Bobik128/jetson-bot/src/lerobot_robot_jetsonbot/lerobot_robot_jetsonbot/jetsonbot_client.py

import base64
import json
import logging
from functools import cached_property

import cv2
import numpy as np
import pygame

from lerobot.processor import RobotAction, RobotObservation
from lerobot.utils.constants import ACTION, OBS_STATE
from lerobot.utils.decorators import check_if_already_connected, check_if_not_connected
from lerobot.utils.errors import DeviceNotConnectedError

from lerobot.robots.robot import Robot
from .config_jetsonbot_client import JetsonBotClientConfig

from dataclasses import dataclass
from typing import Dict, Tuple


def clamp(x: float, lo: float, hi: float) -> float:
    return lo if x < lo else hi if x > hi else x


def apply_deadzone(x: float, dz: float) -> float:
    return 0.0 if abs(x) < dz else x


def expo_curve(x: float, expo: float) -> float:
    """
    expo in [0..1]. 0 = linear, 1 = very soft around center.
    """
    x = clamp(x, -1.0, 1.0)
    expo = clamp(expo, 0.0, 1.0)
    return (1.0 - expo) * x + expo * (x * x * x)


class JetsonBotClient(Robot):
    config_class = JetsonBotClientConfig
    name = "jetsonbot_client"

    def __init__(self, config: JetsonBotClientConfig):
        import zmq

        self._zmq = zmq
        super().__init__(config)
        self.config = config
        self.id = config.id
        self.robot_type = config.type

        self.remote_ip = config.remote_ip
        self.port_zmq_cmd = config.port_zmq_cmd
        self.port_zmq_observations = config.port_zmq_observations

        self.teleop_keys = config.teleop_keys

        self.polling_timeout_ms = config.polling_timeout_ms
        self.connect_timeout_s = config.connect_timeout_s

        self.zmq_context = None
        self.zmq_cmd_socket = None
        self.zmq_observation_socket = None

        self.last_frames = {}

        self.last_remote_state = {}

        # Define three speed levels and a current index
        self.speed_levels = [
            {"v": 0.2, "w": 1.0},  # slow
            {"v": 0.3, "w": 2.0},  # medium
            {"v": 0.4, "w": 3.0},  # fast
        ]
        self.speed_index = 0  # Start at slow

        self._is_connected = False
        self.logs = {}

    @cached_property
    def _state_ft(self) -> dict[str, type]:
        return dict.fromkeys(
            (
                "arm_shoulder_lift.pos",
                "arm_elbow_flex.pos",
                "arm_wrist_flex.pos",
                "arm_gripper.pos",
                "motor_linear.vel",
                "motor_angular.vel",
            ),
            float,
        )
    
    @cached_property
    def _obs_state_ft(self) -> dict[str, type]:
        # observation-only state = state_ft + gyro
        return {**self._state_ft, "gyro_yaw.vel": float}
    

    @cached_property
    def _state_order(self) -> tuple[str, ...]:
        return tuple(self._state_ft.keys())
        
    @cached_property
    def _obs_state_order(self) -> tuple[str, ...]:
        # used for observation dict + OBS_STATE vector
        return tuple(self._obs_state_ft.keys())

    @cached_property
    def _cameras_ft(self) -> dict[str, tuple[int, int, int]]:
        return {name: (cfg.height, cfg.width, 3) for name, cfg in self.config.cameras.items()}

    @cached_property
    def observation_features(self) -> dict[str, type | tuple]:
        return {**self._obs_state_ft, **self._cameras_ft}

    @cached_property
    def action_features(self) -> dict[str, type]:
        return self._state_ft

    @property
    def is_connected(self) -> bool:
        return self._is_connected

    @property
    def is_calibrated(self) -> bool:
        pass

    # def read_dualsense_base_action(
    #     self,
    #     js: pygame.joystick.Joystick,
    #     cfg: GamepadConfig = GamepadConfig(),
    # ) -> Dict[str, float]:
    #     """
    #     Read controller axes and return LeRobot base action:
    #         {"motor_linear.vel": v_cmd, "motor_angular.vel": w_cmd}

    #     IMPORTANT: call pygame.event.pump() ONCE per control loop before reading.
    #     """
    #     # Make sure pygame internal state is updated (do this once per loop)
    #     pygame.event.pump()

    #     # Read raw axes in [-1, 1] (typically)
    #     fwd = float(js.get_axis(cfg.axis_forward))
    #     turn = float(js.get_axis(cfg.axis_turn))

    #     if cfg.invert_forward:
    #         fwd = -fwd
    #     if cfg.invert_turn:
    #         turn = -turn

    #     # Deadzone + expo shaping
    #     fwd = expo_curve(apply_deadzone(fwd, cfg.deadzone), cfg.expo)
    #     turn = expo_curve(apply_deadzone(turn, cfg.deadzone), cfg.expo)

    #     # Optional turbo from trigger
    #     scale = 1.0
    #     if cfg.use_turbo:
    #         try:
    #             raw = float(js.get_axis(cfg.axis_turbo))  # often [-1..1]
    #             turbo = (raw + 1.0) * 0.5                # -> [0..1]
    #             turbo = clamp(turbo, 0.0, 1.0)
    #             scale = cfg.turbo_min_scale + (1.0 - cfg.turbo_min_scale) * turbo
    #         except Exception:
    #             scale = 1.0

    #     v_cmd = fwd * cfg.max_v_mps * scale
    #     w_cmd = turn * cfg.max_w_radps * scale

    #     # Final clamp (safety)
    #     v_cmd = clamp(v_cmd, -cfg.max_v_mps, cfg.max_v_mps)
    #     w_cmd = clamp(w_cmd, -cfg.max_w_radps, cfg.max_w_radps)

    #     return {
    #         "motor_linear.vel": v_cmd,
    #         "motor_angular.vel": w_cmd,
    #     }

    @check_if_already_connected
    def connect(self) -> None:
        """Establishes ZMQ sockets with the remote mobile robot"""

        zmq = self._zmq
        self.zmq_context = zmq.Context()
        self.zmq_cmd_socket = self.zmq_context.socket(zmq.PUSH)
        zmq_cmd_locator = f"tcp://{self.remote_ip}:{self.port_zmq_cmd}"
        self.zmq_cmd_socket.connect(zmq_cmd_locator)
        self.zmq_cmd_socket.setsockopt(zmq.CONFLATE, 1)

        self.zmq_observation_socket = self.zmq_context.socket(zmq.PULL)
        zmq_observations_locator = f"tcp://{self.remote_ip}:{self.port_zmq_observations}"
        self.zmq_observation_socket.connect(zmq_observations_locator)
        self.zmq_observation_socket.setsockopt(zmq.CONFLATE, 1)

        poller = zmq.Poller()
        poller.register(self.zmq_observation_socket, zmq.POLLIN)
        socks = dict(poller.poll(self.connect_timeout_s * 1000))
        if self.zmq_observation_socket not in socks or socks[self.zmq_observation_socket] != zmq.POLLIN:
            raise DeviceNotConnectedError("Timeout waiting for JetsonBot Host to connect expired.")

        self._is_connected = True

    def calibrate(self) -> None:
        pass

    def _poll_and_get_latest_message(self) -> str | None:
        """Polls the ZMQ socket for a limited time and returns the latest message string."""
        zmq = self._zmq
        poller = zmq.Poller()
        poller.register(self.zmq_observation_socket, zmq.POLLIN)

        try:
            socks = dict(poller.poll(self.polling_timeout_ms))
        except zmq.ZMQError as e:
            logging.error(f"ZMQ polling error: {e}")
            return None

        if self.zmq_observation_socket not in socks:
            logging.info("No new data available within timeout.")
            return None

        last_msg = None
        while True:
            try:
                msg = self.zmq_observation_socket.recv_string(zmq.NOBLOCK)
                last_msg = msg
            except zmq.Again:
                break

        if last_msg is None:
            logging.warning("Poller indicated data, but failed to retrieve message.")

        return last_msg

    def _parse_observation_json(self, obs_string: str) -> RobotObservation | None:
        """Parses the JSON observation string."""
        try:
            return json.loads(obs_string)
        except json.JSONDecodeError as e:
            logging.error(f"Error decoding JSON observation: {e}")
            return None

    # def _decode_image_from_b64(self, image_b64: str) -> np.ndarray | None:
    #     """Decodes a base64 encoded image string to an OpenCV image."""
    #     if not image_b64:
    #         return None
    #     try:
    #         jpg_data = base64.b64decode(image_b64)
    #         np_arr = np.frombuffer(jpg_data, dtype=np.uint8)
    #         frame = cv2.imdecode(np_arr, cv2.IMREAD_COLOR)
    #         if frame is None:
    #             logging.warning("cv2.imdecode returned None for an image.")
    #         return frame
    #     except (TypeError, ValueError) as e:
    #         logging.error(f"Error decoding base64 image data: {e}")
    #         return None

    def _decode_image_from_b64(self, image_b64: str) -> np.ndarray | None:
        """Decodes a base64 encoded JPEG string to an RGB image."""
        if not image_b64:
            return None
        try:
            jpg_data = base64.b64decode(image_b64)
            np_arr = np.frombuffer(jpg_data, dtype=np.uint8)
            frame_bgr = cv2.imdecode(np_arr, cv2.IMREAD_COLOR)
            if frame_bgr is None:
                logging.warning("cv2.imdecode returned None for an image.")
                return None
            frame_rgb = cv2.cvtColor(frame_bgr, cv2.COLOR_BGR2RGB)
            return frame_rgb
        except (TypeError, ValueError) as e:
            logging.error(f"Error decoding base64 image data: {e}")
            return None

    def _remote_state_from_obs(
        self, observation: RobotObservation
    ) -> tuple[dict[str, np.ndarray], RobotObservation]:
        """Extracts frames, and state from the parsed observation."""

        flat_state = {key: observation.get(key, 0.0) for key in self._obs_state_order}
        state_vec = np.array([flat_state[key] for key in self._obs_state_order], dtype=np.float32)
        obs_dict: RobotObservation = {**flat_state, OBS_STATE: state_vec}

        # Decode images
        current_frames: dict[str, np.ndarray] = {}
        for cam_name, image_b64 in observation.items():
            if cam_name not in self._cameras_ft:
                continue
            frame = self._decode_image_from_b64(image_b64)
            if frame is not None:
                current_frames[cam_name] = frame

        return current_frames, obs_dict

    def _get_data(self) -> tuple[dict[str, np.ndarray], RobotObservation]:
        """
        Polls the video socket for the latest observation data.

        Attempts to retrieve and decode the latest message within a short timeout.
        If successful, updates and returns the new frames, speed, and arm state.
        If no new data arrives or decoding fails, returns the last known values.
        """

        # 1. Get the latest message string from the socket
        latest_message_str = self._poll_and_get_latest_message()

        # 2. If no message, return cached data
        if latest_message_str is None:
            return self.last_frames, self.last_remote_state

        # 3. Parse the JSON message
        observation = self._parse_observation_json(latest_message_str)

        # 4. If JSON parsing failed, return cached data
        if observation is None:
            return self.last_frames, self.last_remote_state

        # 5. Process the valid observation data
        try:
            new_frames, new_state = self._remote_state_from_obs(observation)
        except Exception as e:
            logging.error(f"Error processing observation data, serving last observation: {e}")
            return self.last_frames, self.last_remote_state

        self.last_frames = new_frames
        self.last_remote_state = new_state

        return new_frames, new_state

    @check_if_not_connected
    def get_observation(self) -> RobotObservation:
        """
        Capture observations from the remote robot: current follower arm positions,
        present wheel speeds (converted to body-frame velocities: x, y, theta),
        and a camera frame. Receives over ZMQ, translate to body-frame vel
        """

        frames, obs_dict = self._get_data()

        # Loop over each configured camera
        for cam_name, frame in frames.items():
            if frame is None:
                logging.warning("Frame is None")
                frame = np.zeros((640, 480, 3), dtype=np.uint8)
            obs_dict[cam_name] = frame

        return obs_dict

    def configure(self):
        pass

    @check_if_not_connected
    def send_action(self, action: RobotAction) -> RobotAction:
        """Command JetsonBot to move to a target joint configuration. Translates to motor space + sends over ZMQ

        Args:
            action (RobotAction): array containing the goal positions for the motors.
        Raises:
            RobotDeviceNotConnectedError: if robot is not connected.

        Returns:
            np.ndarray: the action sent to the motors, potentially clipped.
        """

        self.zmq_cmd_socket.send_string(json.dumps(action))  # action is in motor space

        # TODO(Steven): Remove the np conversion when it is possible to record a non-numpy array value
        actions = np.array([action.get(k, 0.0) for k in self._state_order], dtype=np.float32)

        action_sent = {key: actions[i] for i, key in enumerate(self._state_order)}
        action_sent[ACTION] = actions
        return action_sent

    @check_if_not_connected
    def disconnect(self):
        """Cleans ZMQ comms"""

        self.zmq_observation_socket.close()
        self.zmq_cmd_socket.close()
        self.zmq_context.term()
        self._is_connected = False
