Bobik128/jetson-bot/(commit log)

2025-12-19 repaired esp32 port
2026-01-07 gripper protection tuner
2026-01-12 repaired the servo1 phenomen
2026-01-13 record print
2026-01-16 fast arm write
2026-01-19 added il run file
2026-01-23 reamde cameras
2026-02-23 frame size change
2026-02-27 added imu
2026-03-03 some gyro record upfdates
2026-04-09 removed cameras
2026-04-09 shouldnt work on jetson
2026-04-09 modified all files for camera wrapper, just needs testing
2026-04-10 camera downgrade
2026-04-10 Revert "revert back to working"
    This reverts commit 79570527b9d6fea471408c849ddf01f1218cb128.
    [config_jetsonbot_client.py, jetsonbot_client.py, jetsonbot_host.py]
2026-05-30 Add software setup instructions to README
    Added detailed setup instructions for Jetson Orin Nano and lerobot installation.
2026-05-30 Update README with motor setup and calibration instructions
    Added instructions for setting up motors and calibrating the robot.
